brunohorta82/BH_GATE_CONTROLLER/README.md

# BH GATE CONTROLLER

* [Intro](#id1)
* [Firmware](https://github.com/brunohorta82/easy_iot)
* [Donativos](#id6)

## Intro 
O BH GATE permite controlar cargas até 30V o que o torna perfeito para controlar portões electricos. A Placa tem suporte até 3 relés REED. É possivel controlar motores que têm interfaces de controlo distintas para Abrir, Fechar e Parar. Para controlar portões em que só utilizam uma interface para controlar todos os estados basta utilizar apenas um relé. A PCB ainda vem com 2 entradas para sensores magnéticos e uma entrada analógica para instalar um sensor de luz (LDR).

## Donativos 

Se gostaste do projeto podes fazer o teu donativo :).



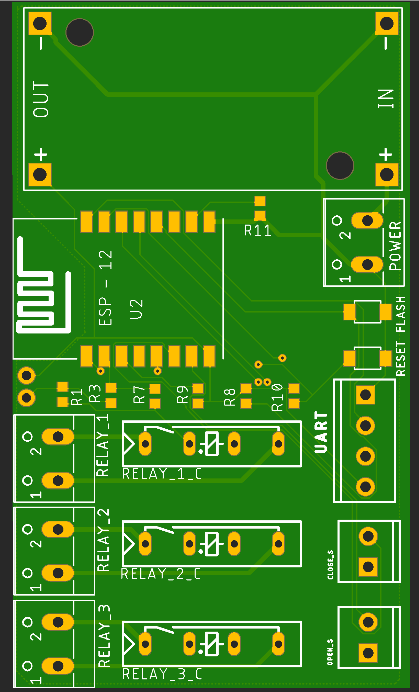
[picture p1: images/pcb.png]
pcb

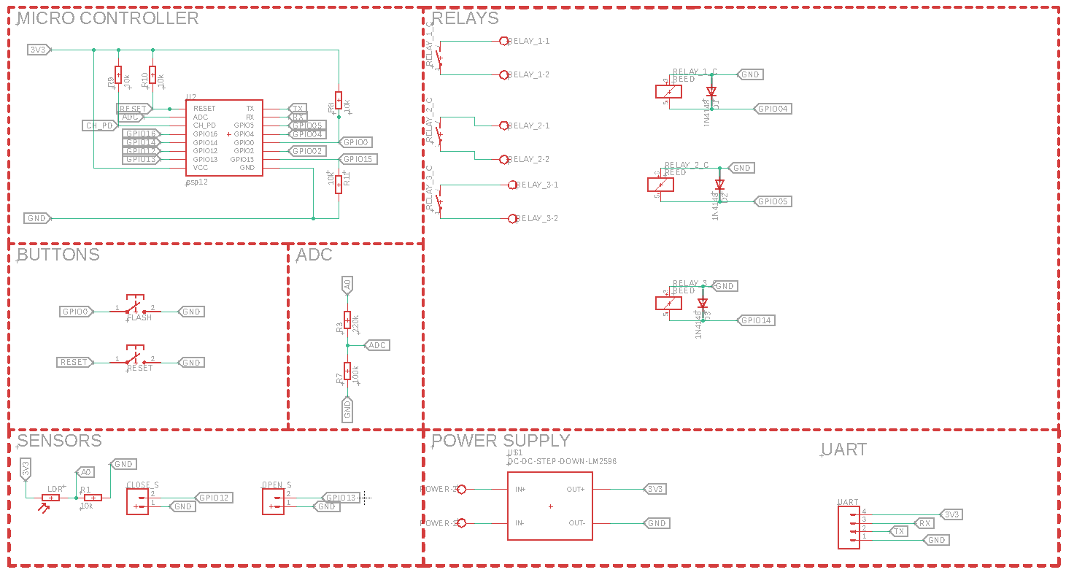
[picture p2: images/sch.png]
sch

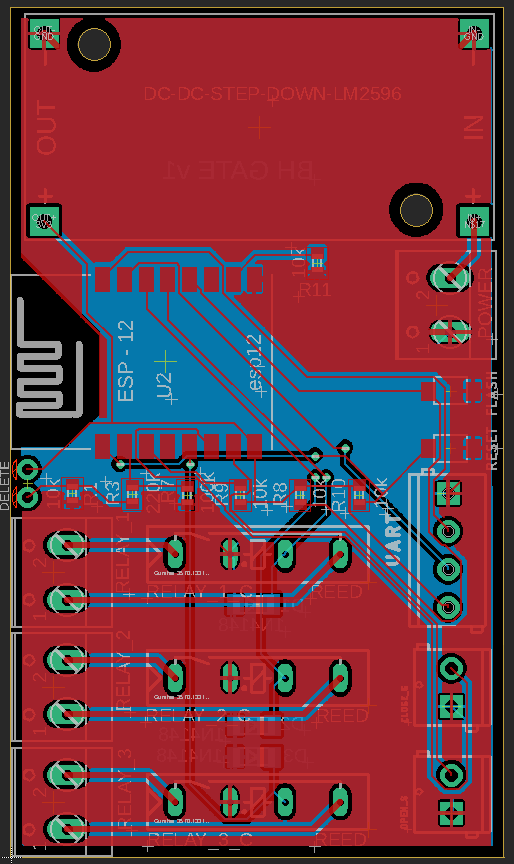
[picture p3: images/brd.png]
brd

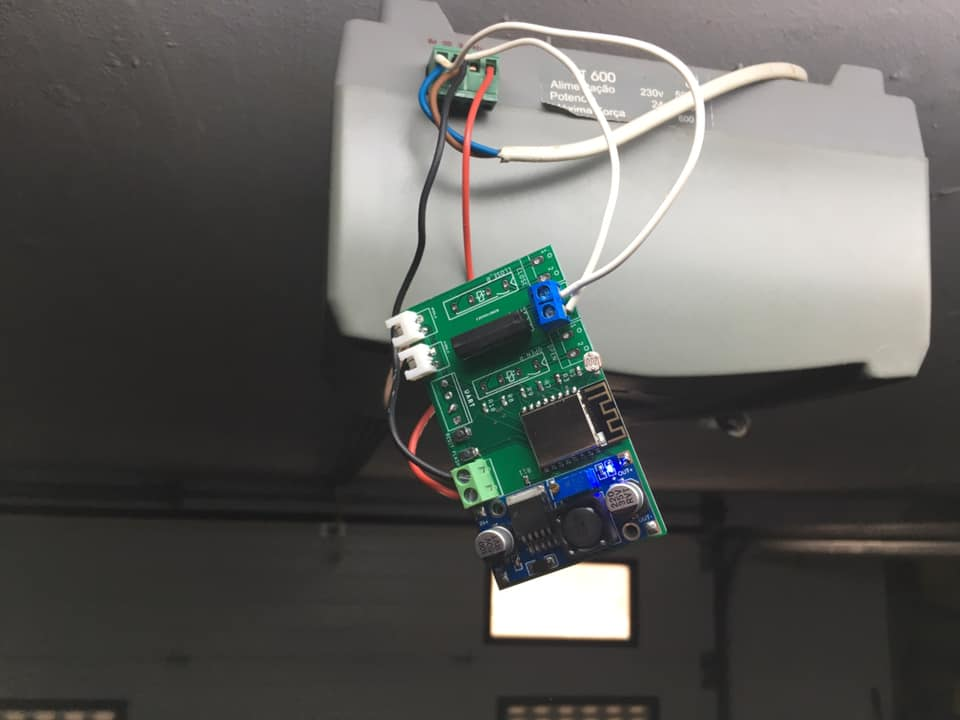
[picture p4: images/gate.jpg]
asb
