brunohorta82/BH_GATE_CONTROLLER/BOX/tampa.stl

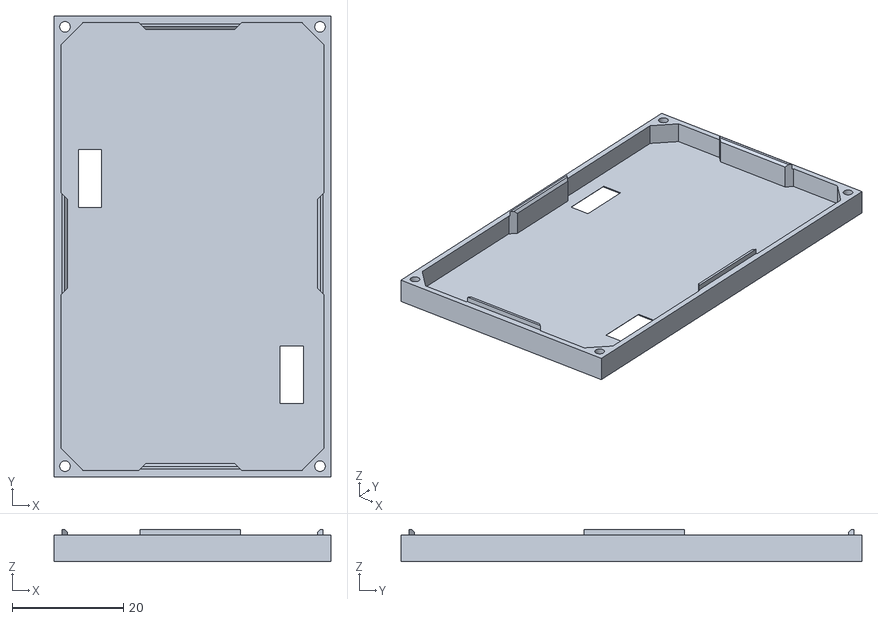
[picture p5: CAD file, 2019-10-16]
BOX/tampa.stl
49.7 x 82.8 x 5.80
