brunohorta82/BH_GATE_CONTROLLER/PCB_2.0/gate.dxf

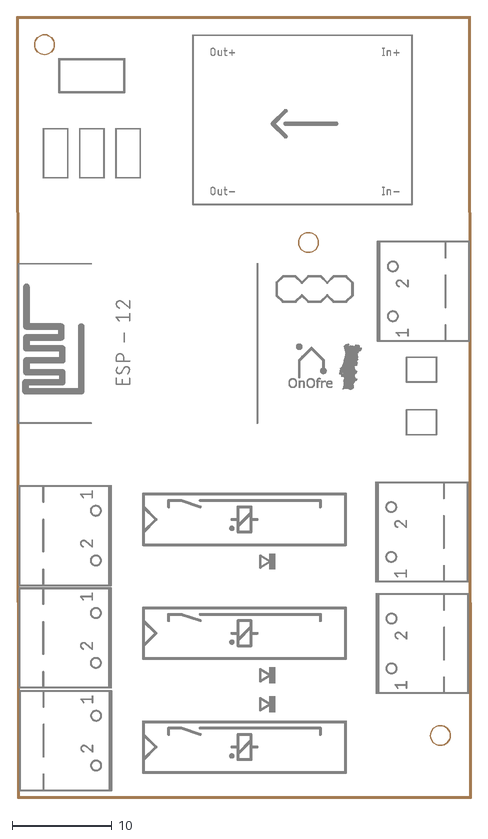
[picture p6: CAD file, 2020-01-28]
PCB_2.0/gate.dxf
45.7 x 78.6
