brunohorta82/BH_GATE_CONTROLLER/PCB_DEV/GATE/gate.dxf

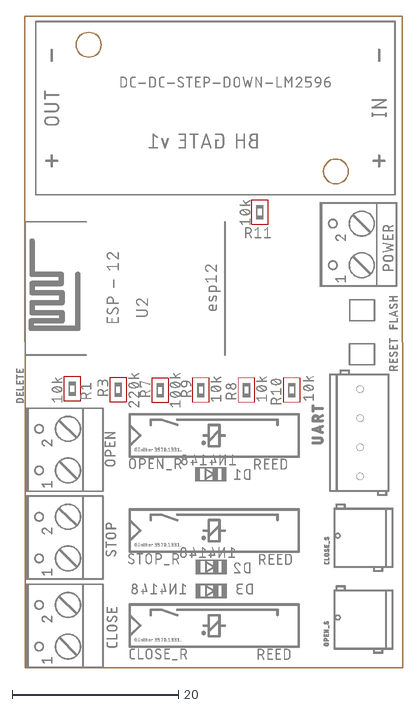
[picture p7: CAD file, 2019-04-08]
PCB_DEV/GATE/gate.dxf
46.5 x 78.4
