brunohorta82/BH_GATE_CONTROLLER/BOX/caixa.stl

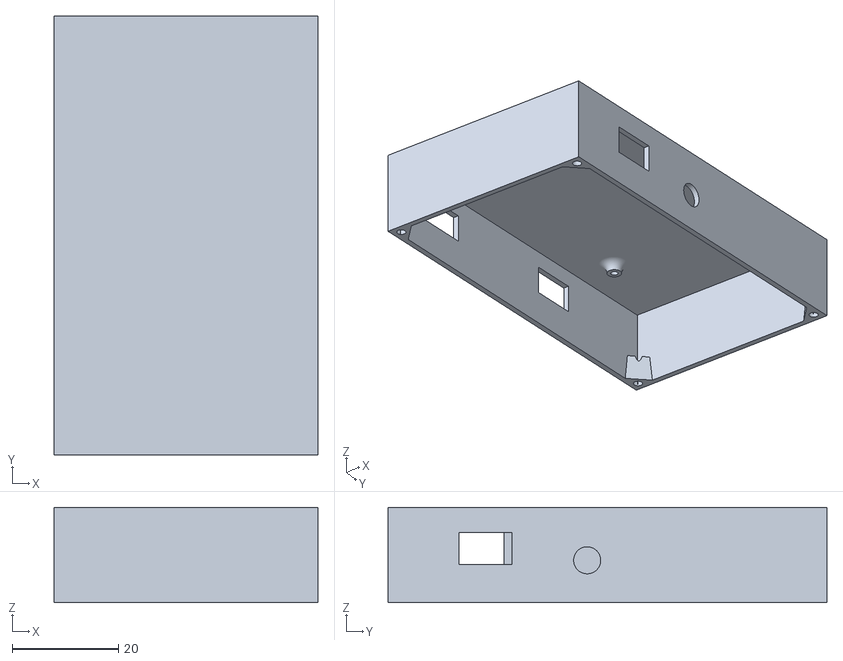
[picture p8: CAD file, 2019-10-16]
BOX/caixa.stl
49.7 x 82.8 x 18.0
