brunohorta82/BH_GATE_CONTROLLER/PCB_2.0/gate.brd

## EAGLE design PCB_2.0/gate.brd (2020-01-28)

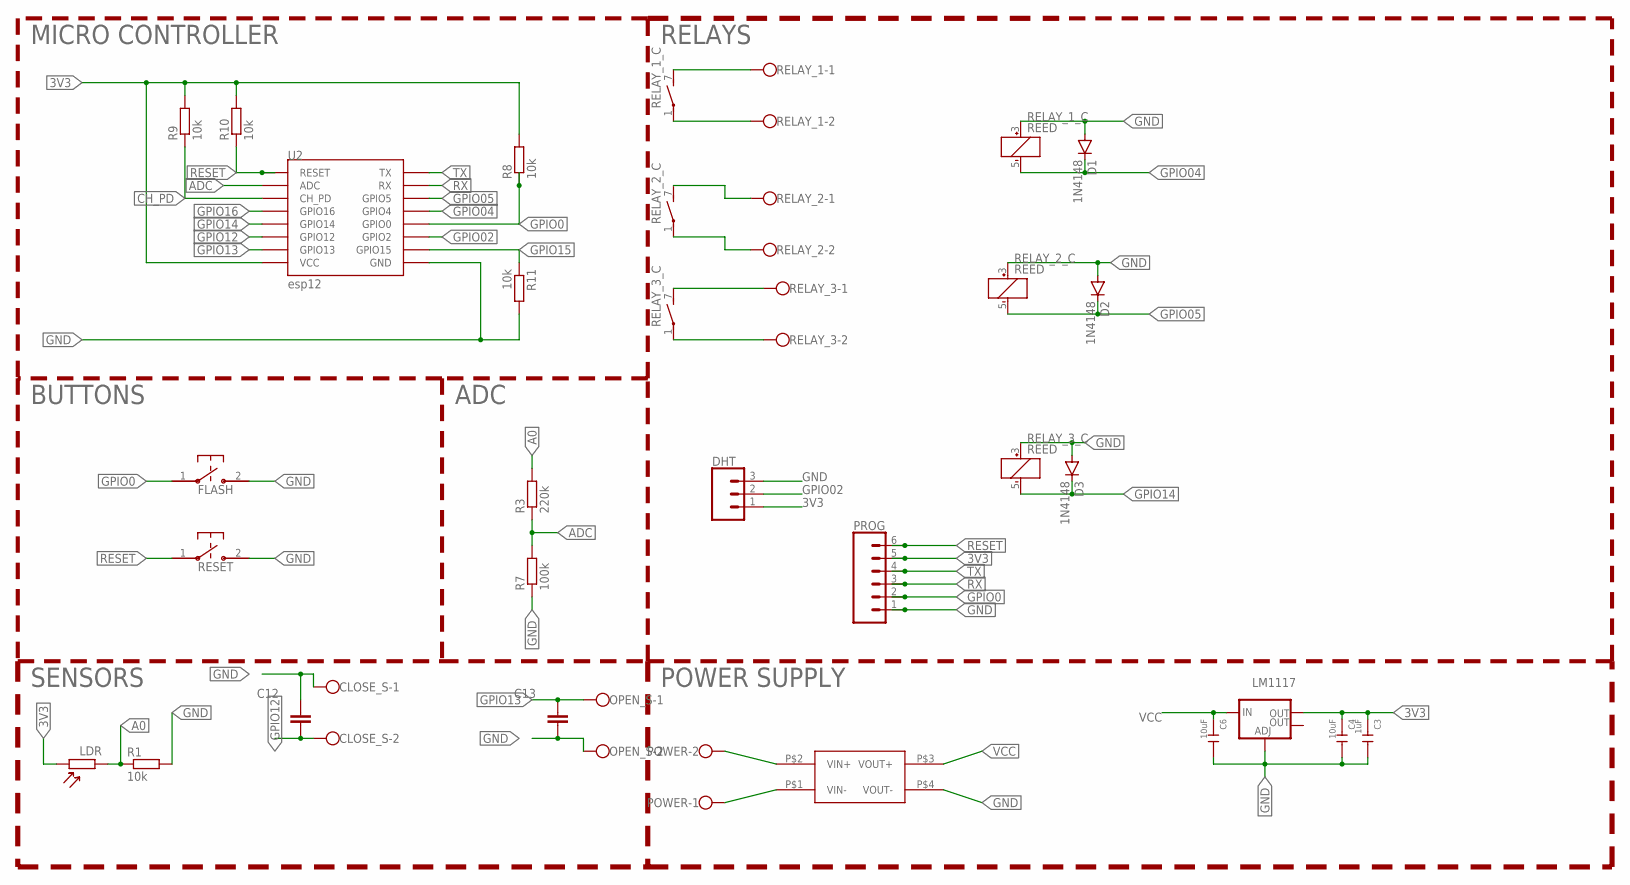
[picture p9: schematic gate.sch]

Parts:
AMS1117: LM1117; SOT223
C3: 1uF; C1206
C4, C6: 10uF; C1206
C12, C13: C-EUC0805; C0805
CLOSE_S: W237-102
D1, D2, D3: 1N4148; SOD80C
DHT: CONN_03; 1X03
FLASH: B3U-1000P-2P-SMD; B3U-1000P
LDR: LDR-TH; 1X02
OPEN_S: W237-102
POWER: W237-102
PROG: CONN_06NO_SILK_NO_POP; 1X06_NO_SILK
R1, R8, R9, R10, R11: 10k; R0603
R3: 220k; R0603
R7: 100k; R0603
RELAY_1, RELAY_2, RELAY_3: W237-102
RELAY_1_C, RELAY_2_C, RELAY_3_C: REED
RESET: B3U-1000P-2P-SMD; B3U-1000P
U2: esp12; ESP12-SMD
U$2: MP1584-MINI-SMDDL; MINI-DC-BRICK_DL-SMD

Connections:
3V3: AMS1117.2 (OUT), C3.1, C4.1, DHT.1, LDR.2, PROG.5, R8.2, R9.2, R10.2, U2.VCC
A0: LDR.1, R1.1, R3.2
ADC: R3.1, R7.2, U2.ADC
CH_PD: R9.1, U2.CH_PD
GND: AMS1117.1 (ADJ), C3.2, C4.2, C6.2, C12.1, C13.2, CLOSE_S.1, D1.A, D2.A, D3.A, DHT.3, FLASH.2, OPEN_S.2, POWER.1, PROG.1, R1.2, R7.1, R11.2, RELAY_1_C.3 (+), RELAY_2_C.3 (+), RELAY_3_C.3 (+), RESET.2, U2.GND, U$2.P$1 (VIN-), U$2.P$4 (VOUT-)
GND1: RELAY_1.1, RELAY_1_C.7 (S)
GND2: RELAY_2.1, RELAY_2_C.7 (S)
GND3: RELAY_3.1, RELAY_3_C.7 (S)
GPIO0: FLASH.1, PROG.2, R8.1, U2.GPIO0
GPIO02: DHT.2, U2.GPIO2
GPIO04: D1.C, RELAY_1_C.5 (-), U2.GPIO4
GPIO05: D2.C, RELAY_2_C.5 (-), U2.GPIO5
GPIO12: C12.2, CLOSE_S.2, U2.GPIO12
GPIO13: C13.1, OPEN_S.1, U2.GPIO13
GPIO14: D3.C, RELAY_3_C.5 (-), U2.GPIO14
GPIO15: R11.1, U2.GPIO15
GPIO16: U2.GPIO16
unnamed: RELAY_1.2, RELAY_1_C.1
unnamed: RELAY_2.2, RELAY_2_C.1
unnamed: RELAY_3.2, RELAY_3_C.1
unnamed: POWER.2, U$2.P$2 (VIN+)
RESET: PROG.6, R10.1, RESET.1, U2.RESET
RX: PROG.3, U2.RXD0 (RX)
TX: PROG.4, U2.TXD0 (TX)
VCC: AMS1117.3 (IN), C6.1, U$2.P$3 (VOUT+)

Notes on the sheet:
BUTTONS
MICRO CONTROLLER
ADC
RELAYS
POWER SUPPLY
SENSORS

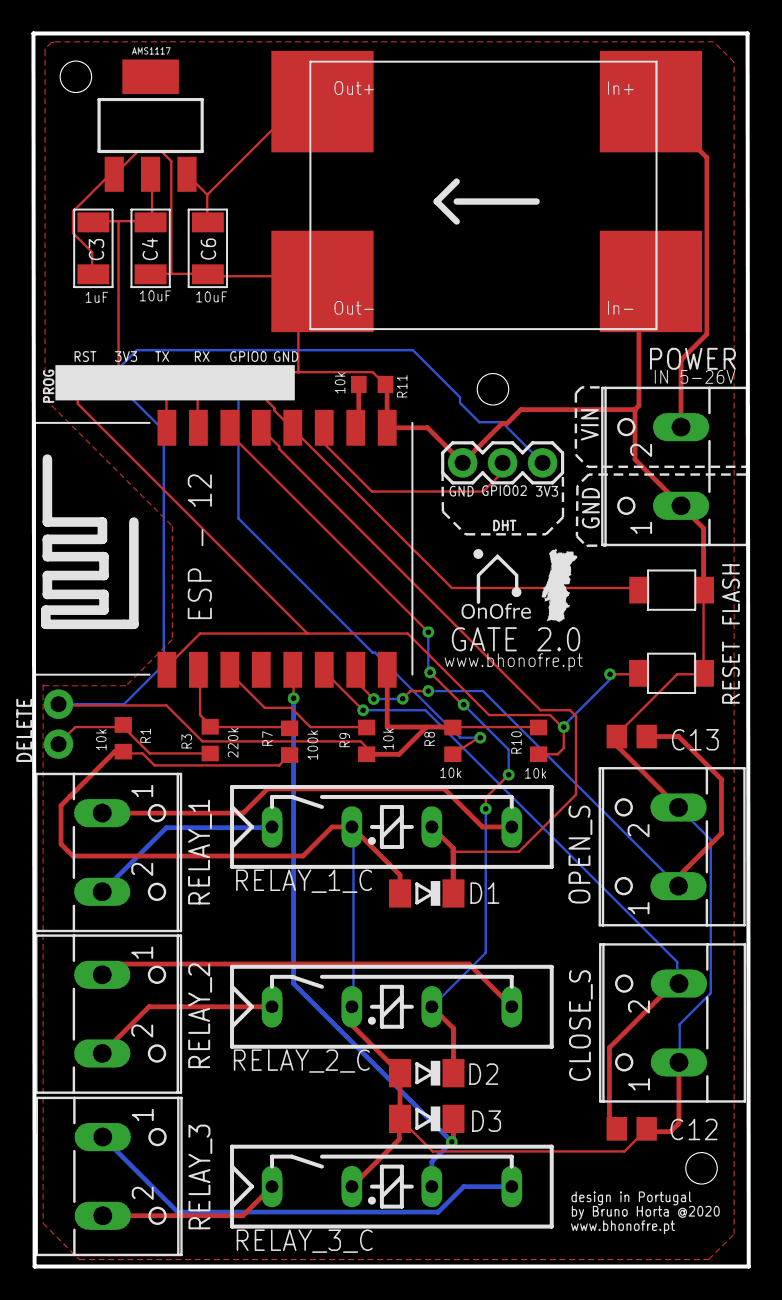
[picture p10: board gate.brd from above]

Board: 2 copper layers, 45.5 x 78.4 mm, 32 parts (0 on the bottom side), 24 nets.
