brunohorta82/BH_GATE_CONTROLLER/(commit log)

2019-03-27 pcb in dev
    [gate.brd, gate.sch]
2019-03-28 pcb done v1
    [gate.brd, gate.sch]
2019-04-08 V1
    V1
    [gate.brd]
2020-01-28 PCB V2.0
    [gate.brd, gate.dxf, gate.sch]
